SimonAnnetts/RFSwitch/RFSwitch/production/README.md

# Gerber files

The zip file contains all the gerber files required to make a PCB.

You can just drag and drop this file on JLCPCB PCB order page to order the PCB.

https://cart.jlcpcb.com/quote?stencilLayer=2&stencilWidth=100&stencilLength=100&stencilCounts=5&plateType=1
