SimonAnnetts/RFSwitch/RFSwitch/production/bom.csv

Designator | Footprint | Quantity | Value | LCSC Part #
C1, C10, C11, C12, C2, C3, C4, C5, C6, C7, C8, C9 | C_Disc_D7.0mm_W2.5mm_P5.00mm | 12 | 100n
C13, C14, C15, C16 | C_Disc_D7.0mm_W2.5mm_P5.00mm | 4 | 2.2pF
J1 | PinHeader_1x08_P2.54mm_Vertical | 1 | ~
L1 | L_Radial_L7.5mm_W4.6mm_P5.00mm_Neosid_SD75 | 1 | 25-33nH 4-5 turns@3mm
Q1, Q2, Q3, Q4, Q5, Q6, Q7, Q8 | TO-92L_Inline_Wide | 8 | J310 | J310
R1 | R_Axial_DIN0204_L3.6mm_D1.6mm_P7.62mm_Horizontal | 1 | 1K
R10, R12, R14, R16 | R_Axial_DIN0204_L3.6mm_D1.6mm_P2.54mm_Vertical | 4 | 15K
R11, R13, R15, R17 | R_Axial_DIN0204_L3.6mm_D1.6mm_P7.62mm_Horizontal | 4 | 15K
R18, R19 | R_Axial_DIN0204_L3.6mm_D1.6mm_P7.62mm_Horizontal | 2 | 10K
R2, R3, R8, R9 | R_Axial_DIN0204_L3.6mm_D1.6mm_P7.62mm_Horizontal | 4 | 100K
R4, R5, R6, R7 | R_Axial_DIN0204_L3.6mm_D1.6mm_P2.54mm_Vertical | 4 | 100K
U1 | DIP-16_W7.62mm_Socket | 1 | 4104
