SimonAnnetts/RFSwitch/RFSwitch/RFSwitch.kicad_pcb

## KiCad design RFSwitch/RFSwitch.kicad_pcb (2026-11-09)

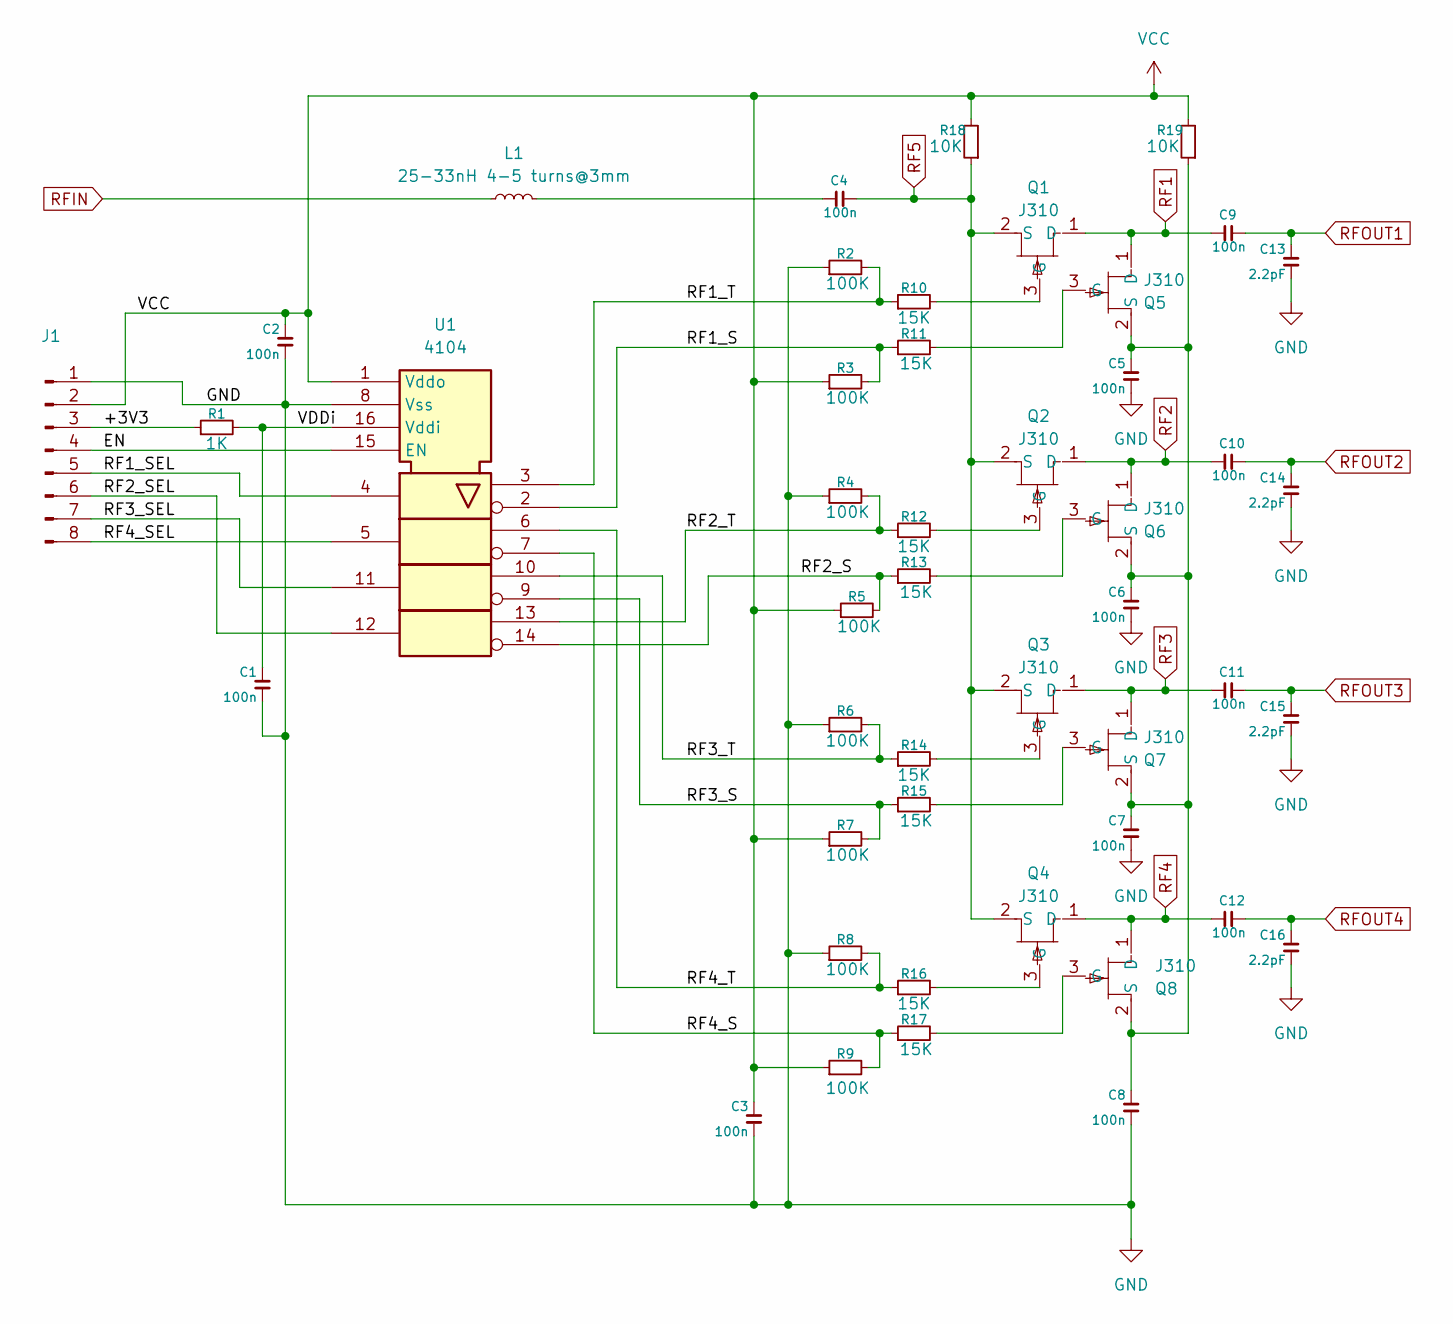
[picture p4: schematic RFSwitch.kicad_sch]

Parts:
C1, C2, C3, C4, C5, C6, C7, C8, C9, C10, C11, C12: 100n; C_Disc_D7.0mm_W2.5mm_P5.00mm
C13, C14, C15, C16: 2.2pF; C_Disc_D7.0mm_W2.5mm_P5.00mm
J1: PinHeader_1x08_P2.54mm_Vertical
L1: 25-33nH 4-5 turns@3mm; L_Radial_L7.5mm_W4.6mm_P5.00mm_Neosid_SD75
Q1, Q2, Q3, Q4, Q5, Q6, Q7, Q8: J310; TO-92L_Inline_Wide; MPN J310
R1: 1K; R_Axial_DIN0204_L3.6mm_D1.6mm_P7.62mm_Horizontal
R2, R3, R8, R9: 100K; R_Axial_DIN0204_L3.6mm_D1.6mm_P7.62mm_Horizontal
R4, R5, R6, R7: 100K; R_Axial_DIN0204_L3.6mm_D1.6mm_P2.54mm_Vertical
R10, R12, R14, R16: 15K; R_Axial_DIN0204_L3.6mm_D1.6mm_P2.54mm_Vertical
R11, R13, R15, R17: 15K; R_Axial_DIN0204_L3.6mm_D1.6mm_P7.62mm_Horizontal
R18, R19: 10K; R_Axial_DIN0204_L3.6mm_D1.6mm_P7.62mm_Horizontal
U1: 4104; DIP-16_W7.62mm_Socket

Connections:
/+3V3: J1.3, R1.1
/EN: J1.4, U1.15 (EN)
/RF1_S: R3.2, R11.1, U1.2
/RF1_SEL: J1.5, U1.4
/RF1_T: R2.2, R10.1, U1.3
/RF2_S: R5.2, R13.1, U1.14
/RF2_SEL: J1.6, U1.12
/RF2_T: R4.2, R12.1, U1.13
/RF3_S: R7.2, R15.1, U1.9
/RF3_SEL: J1.7, U1.11
/RF3_T: R6.2, R14.1, U1.10
/RF4_S: R9.2, R17.1, U1.7
/RF4_SEL: J1.8, U1.5
/RF4_T: R8.2, R16.1, U1.6
/VDDi: C1.1, R1.2, U1.16 (Vddi)
GND: C1.2, C2.2, C3.2, C5.2, C6.2, C7.2, C8.2, C13.2, C14.2, C15.2, C16.2, J1.1, R2.1, R4.1, R6.1, R8.1, U1.8 (Vss)
unnamed: C4.2, L1.2
unnamed: Q1.3 (G), R10.2
unnamed: Q2.3 (G), R12.2
unnamed: Q3.3 (G), R14.2
unnamed: Q4.3 (G), R16.2
unnamed: Q5.3 (G), R11.2
unnamed: C5.1, C6.1, C7.1, C8.1, Q5.2 (S), Q6.2 (S), Q7.2 (S), Q8.2 (S), R19.1
unnamed: Q6.3 (G), R13.2
unnamed: Q7.3 (G), R15.2
unnamed: Q8.3 (G), R17.2
RF1: C9.2, Q1.1 (D), Q5.1 (D)
RF2: C10.2, Q2.1 (D), Q6.1 (D)
RF3: C11.2, Q3.1 (D), Q7.1 (D)
RF4: C12.2, Q4.1 (D), Q8.1 (D)
RF5: C4.1, Q1.2 (S), Q2.2 (S), Q3.2 (S), Q4.2 (S), R18.1
RFIN: L1.1; also elsewhere on the board
RFOUT1: C9.1, C13.1; also elsewhere on the board
RFOUT2: C10.1, C14.1; also elsewhere on the board
RFOUT3: C11.1, C15.1; also elsewhere on the board
RFOUT4: C12.1, C16.1; also elsewhere on the board
VCC: C2.1, C3.1, J1.2, R3.1, R5.1, R7.1, R9.1, R18.2, R19.2, U1.1 (Vddo)

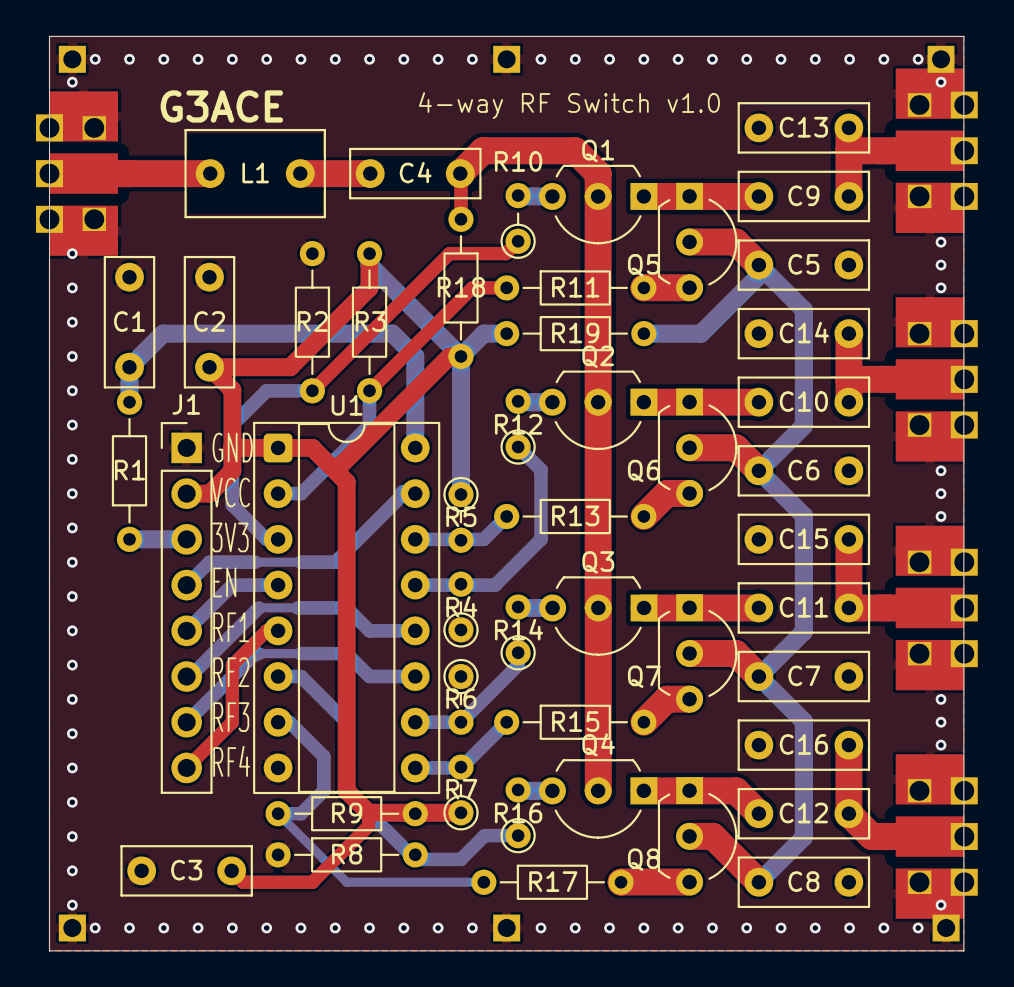
[picture p5: board RFSwitch.kicad_pcb from above]

Board: 2 copper layers, 50.8 x 50.8 mm, 51 parts (0 on the bottom side), 37 nets.

Other parts of the board:
CP1, CP2, CP2#2, CP2#3, CP2#4: 50R; SMD_TrackEnd_1.5x1.5_mask

Their connections:
RFIN: CP1.1 (50_1); also elsewhere on the board
RFOUT1: CP2#4.1 (50); also elsewhere on the board
RFOUT2: CP2#3.1 (50); also elsewhere on the board
RFOUT3: CP2.1 (50); also elsewhere on the board
RFOUT4: CP2#2.1 (50); also elsewhere on the board
