SimonAnnetts/RFSwitch/(commit log)

2026-11-09 Add Kicad schematic, PCB and gerbers
    [RFSwitch.kicad_pcb, RFSwitch.kicad_sch, bom.csv, designators.csv, positions.csv]
2026-11-09 Update Gerber readme
